atyapkin/S23-16_5G-mmWave-Up-Down-Converter-FPGA-Mezzanine-Card/S23-16_PCB/Downconverter.kicad_sch

## KiCad design S23-16_PCB/Downconverter.kicad_sch (2023-04-20)

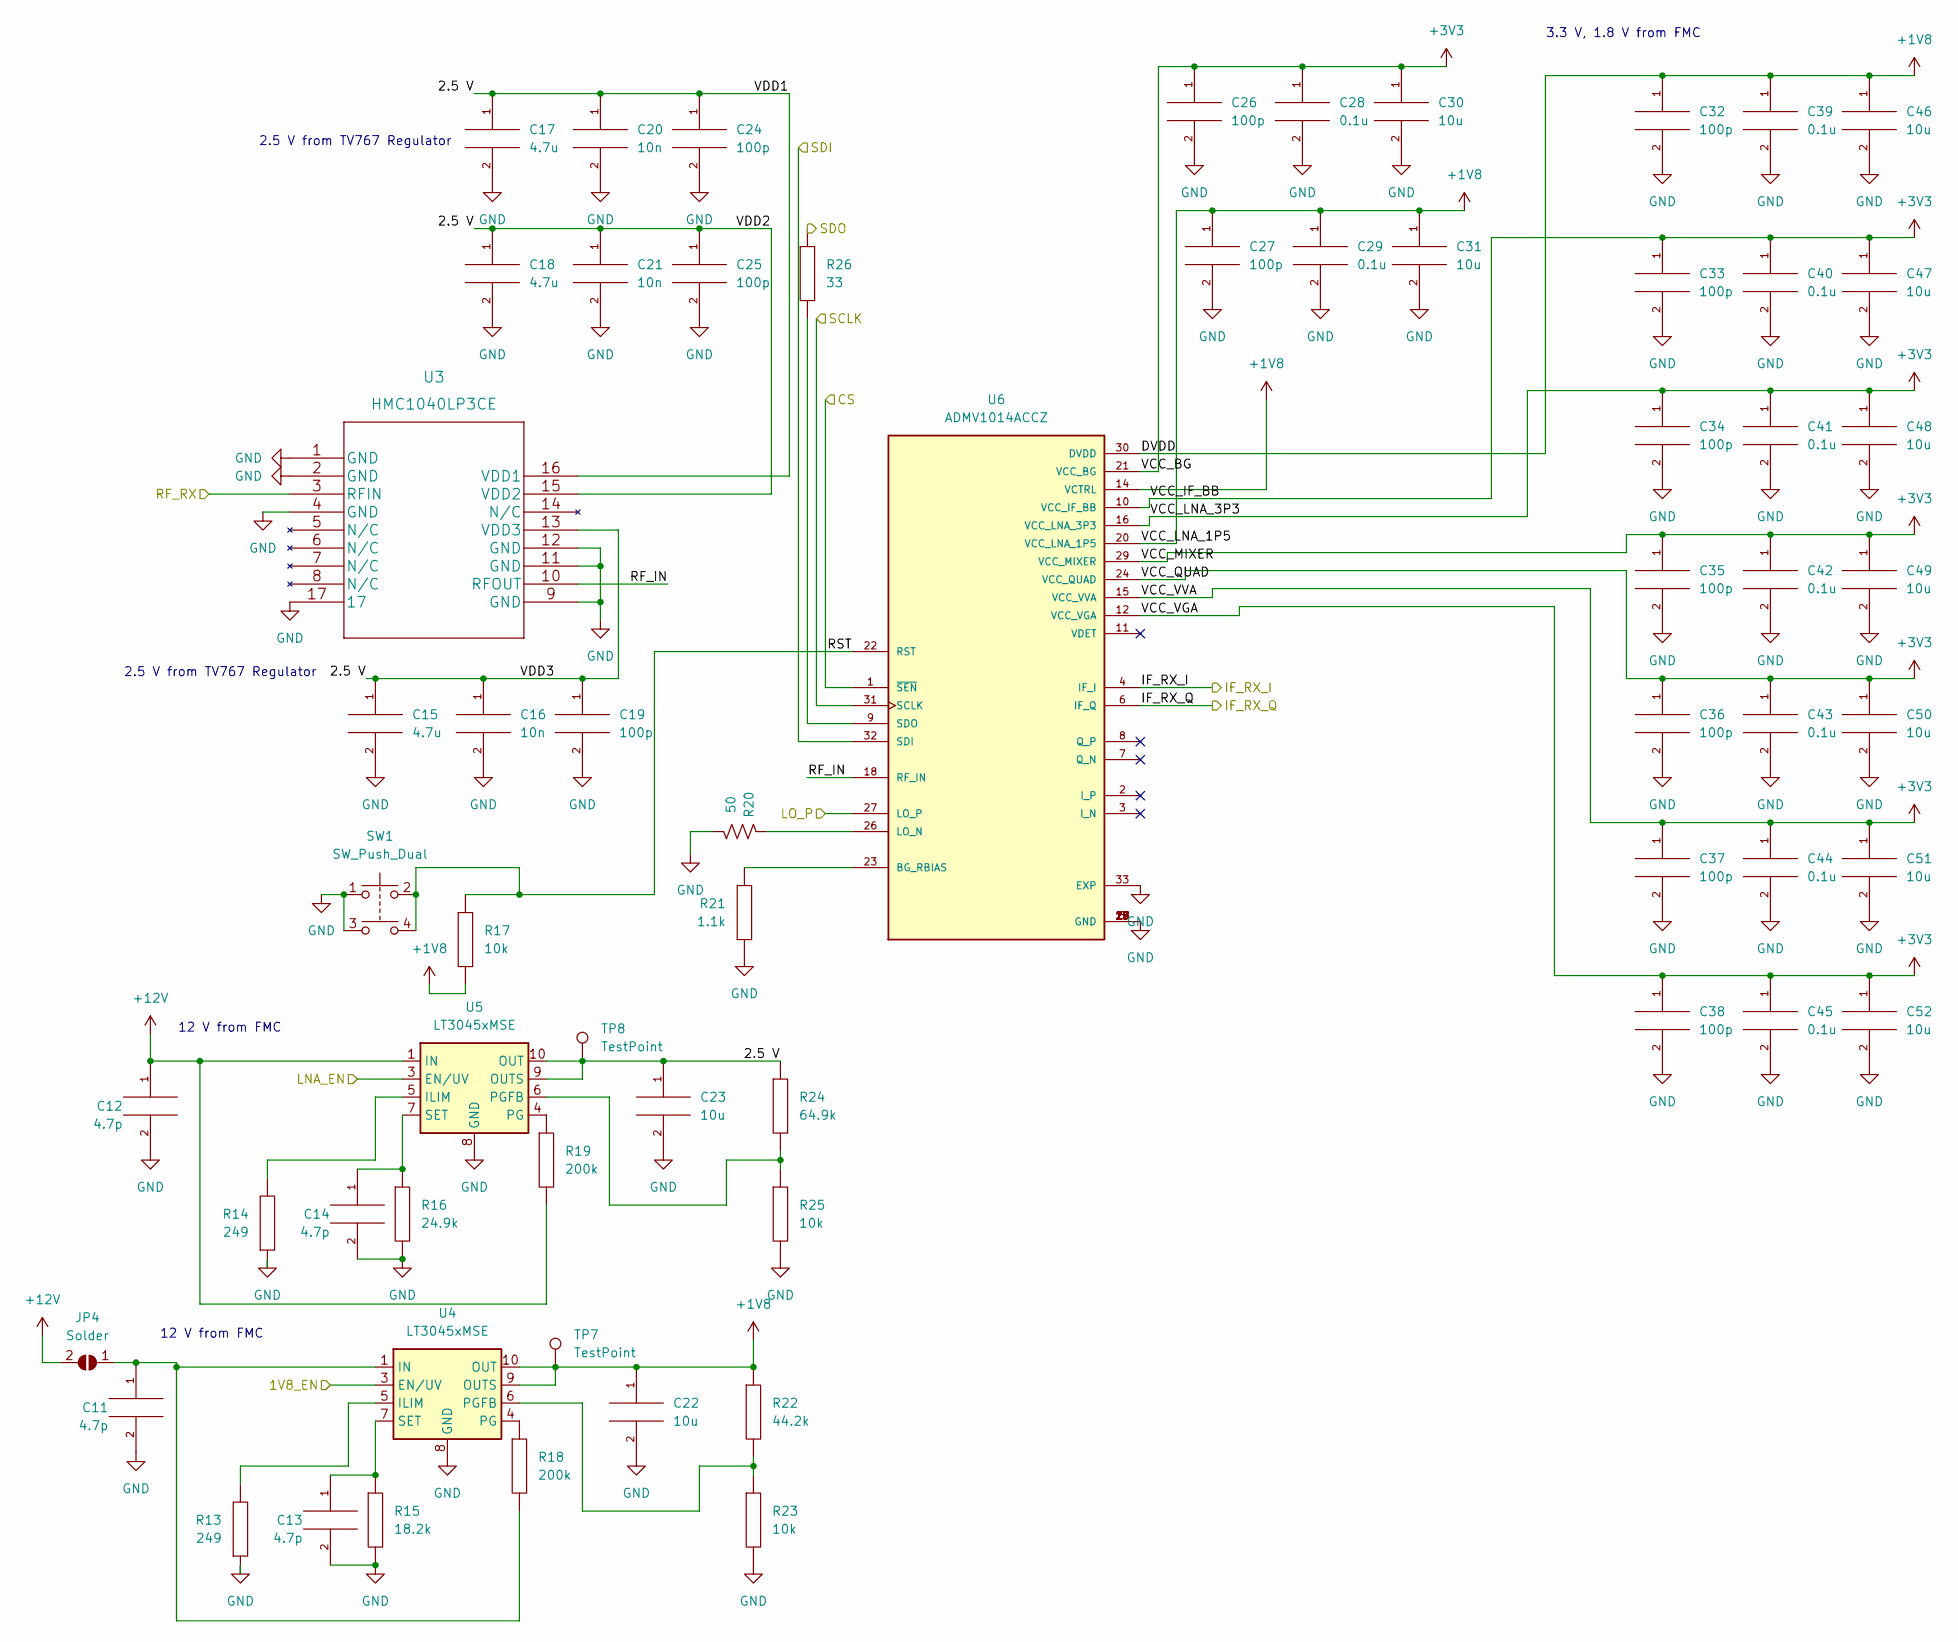
[picture p1: schematic Downconverter.kicad_sch]

Parts:
C11, C12, C13, C14: 4.7p; C_0402_1005Metric
C15, C17, C18: 4.7u; C_0402_1005Metric
C16, C20, C21: 10n; C_0402_1005Metric
C19, C24, C25, C26, C27, C32, C33, C34, C35, C36, C37, C38: 100p; C_0402_1005Metric
C22, C23: 10u; CP_EIA-3216-18_Kemet-A
C28, C29, C39, C40, C41, C42, C43, C44, C45: 0.1u; C_0402_1005Metric
C30, C31, C46, C47, C48, C49, C50, C51, C52: 10u; C_0402_1005Metric
JP4: Solder; SolderJumper-2_P1.3mm_Open_RoundedPad1.0x1.5mm
R13, R14: 249; R_0402_1005Metric
R15: 18.2k; R_0402_1005Metric
R16: 24.9k; R_0402_1005Metric
R17, R23, R25: 10k; R_0402_1005Metric
R18, R19: 200k; R_0402_1005Metric
R20: 50; R_0402_1005Metric
R21: 1.1k; R_0402_1005Metric
R22: 44.2k; R_0402_1005Metric
R24: 64.9k; R_0402_1005Metric
R26: 33; R_0402_1005Metric
SW1: SW_Push_Dual; SW_TL6330AF200Q
TP7, TP8: TestPoint; TestPoint_Loop_D2.50mm_Drill1.0mm
U3: HMC1040LP3CE
U4, U5: LT3045xMSE; DFN-10-1EP_3x3mm_P0.5mm_EP1.65x2.38mm
U6: ADMV1014ACCZ; PARTREV A

Connections:
1V8_EN: U4.3 (EN/UV)
2.5 V: C15.1, C16.1, C17.1, C18.1, C19.1, C20.1, C21.1, C23.1, C24.1, C25.1, R24.1, TP8.1, U3.13 (VDD3), U3.15 (VDD2), U3.16 (VDD1), U5.9 (OUTS), U5.10 (OUT), U5.12 (OUT)
+1V8: C22.1, C27.1, C29.1, C31.1, C32.1, C39.1, C46.1, R17.2, R22.1, TP7.1, U4.9 (OUTS), U4.10 (OUT), U4.12 (OUT), U6.14 (VCTRL), U6.20 (VCC_LNA_1P5), U6.30 (DVDD)
+3V3: C26.1, C28.1, C30.1, C33.1, C34.1, C35.1, C36.1, C37.1, C38.1, C40.1, C41.1, C42.1, C43.1, C44.1, C45.1, C47.1, C48.1, C49.1, C50.1, C51.1, C52.1, U6.10 (VCC_IF_BB), U6.12 (VCC_VGA), U6.15 (VCC_VVA), U6.16 (VCC_LNA_3P3), U6.21 (VCC_BG), U6.24 (VCC_QUAD), U6.29 (VCC_MIXER)
+12V: C12.1, JP4.2 (B), R19.2, U5.1 (IN), U5.2 (IN)
CS: U6.1 (~SEN)
GND: C11.2, C12.2, C13.2, C14.2, C15.2, C16.2, C17.2, C18.2, C19.2, C20.2, C21.2, C22.2, C23.2, C24.2, C25.2, C26.2, C27.2, C28.2, C29.2, C30.2, C31.2, C32.2, C33.2, C34.2, C35.2, C36.2, C37.2, C38.2, C39.2, C40.2, C41.2, C42.2, C43.2, C44.2, C45.2, C46.2, C47.2, C48.2, C49.2, C50.2, C51.2, C52.2, R13.1, R14.1, R15.2, R16.2, R20.1, R21.1, R23.2, R25.2, SW1.1, SW1.3, U3.1 (GND), U3.2 (GND), U3.4 (GND), U3.9 (GND), U3.11 (GND), U3.12 (GND), U3.17, U4.8 (GND), U4.11 (GND), U5.8 (GND), U5.11 (GND), U6.5 (GND), U6.13 (GND), U6.17 (GND), U6.19 (GND), U6.25 (GND), U6.28 (GND), U6.33 (EXP)
IF_RX_I: U6.4 (IF_I)
IF_RX_Q: U6.6 (IF_Q)
LNA_EN: U5.3 (EN/UV)
LO_P: U6.27 (LO_P)
unnamed: C11.1, JP4.1 (A), R18.2, U4.1 (IN), U4.2 (IN)
unnamed: C13.1, R15.1, U4.7 (SET)
unnamed: C14.1, R16.1, U5.7 (SET)
unnamed: R13.2, U4.5 (ILIM)
unnamed: R14.2, U5.5 (ILIM)
unnamed: R18.1, U4.4 (PG)
unnamed: R19.1, U5.4 (PG)
unnamed: R20.2, U6.26 (LO_N)
unnamed: R21.2, U6.23 (BG_RBIAS)
unnamed: R22.2, R23.1, U4.6 (PGFB)
unnamed: R24.2, R25.1, U5.6 (PGFB)
unnamed: R26.2, U6.9 (SDO)
RF_IN: U3.10 (RFOUT), U6.18 (RF_IN)
RF_RX: U3.3 (RFIN)
RST: R17.1, SW1.2, SW1.4, U6.22 (RST)
SCLK: U6.31 (SCLK)
SDI: U6.32 (SDI)
SDO: R26.1

Notes on the sheet:
12 V from FMC
3.3 V, 1.8 V from FMC
2.5 V from TV767 Regulator
