atyapkin/S23-16_5G-mmWave-Up-Down-Converter-FPGA-Mezzanine-Card/S23-16_PCB/FMC_plus.kicad_sch

## KiCad design S23-16_PCB/FMC_plus.kicad_sch (2023-04-20)

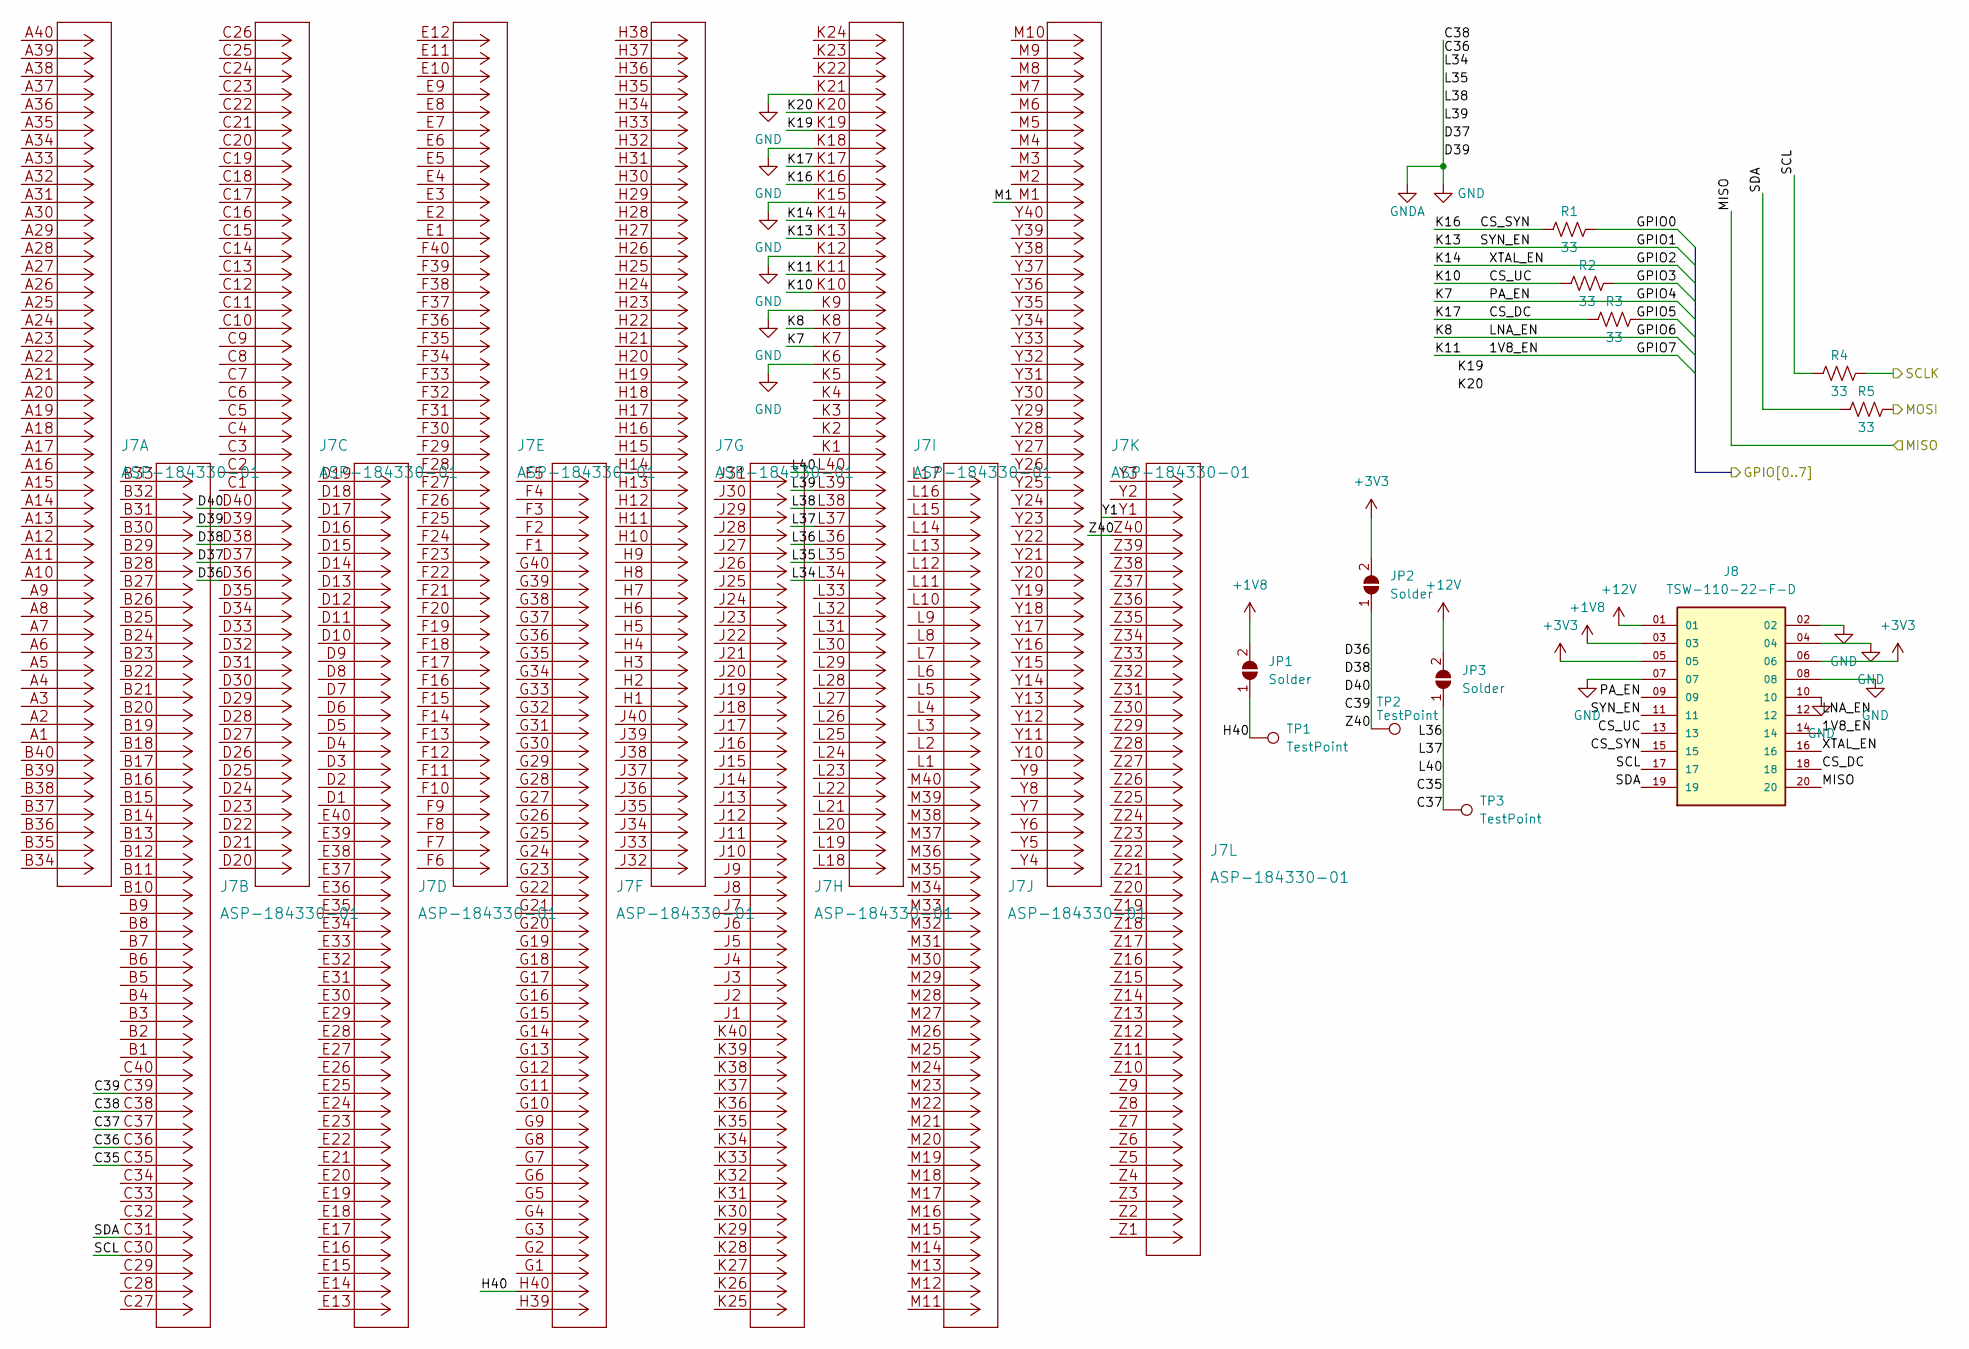
[picture p2: schematic FMC_plus.kicad_sch]

Parts:
J7: ASP-184330-01
J8: TSW-110-22-F-D; SAMTEC_TSW-110-22-F-D; PARTREV R
JP1, JP2, JP3: Solder; SolderJumper-2_P1.3mm_Open_RoundedPad1.0x1.5mm
R1, R2, R3, R4, R5: 33; R_0402_1005Metric
TP1, TP2, TP3: TestPoint; TestPoint_Loop_D2.50mm_Drill1.0mm

Connections:
1V8_EN: J7.K11, J8.14
+1V8: J8.03, JP1.2 (B)
+3V3: J8.05, J8.06, JP2.2 (B)
+12V: J8.01, JP3.2 (B)
C35: J7.C35, J7.C37, J7.L36, J7.L37, J7.L40, JP3.1 (A), TP3.1
C39: J7.C39, J7.D36, J7.D38, J7.D40, J7.Z40, JP2.1 (A), TP2.1
CS_DC: J7.K17, J8.18, R3.1
CS_SYN: J7.K16, J8.15, R1.1
CS_UC: J7.K10, J8.13, R2.1
GND: J7.C36, J7.C38, J7.D37, J7.D39, J7.K6, J7.K9, J7.K12, J7.K15, J7.K18, J7.K21, J7.L34, J7.L35, J7.L38, J7.L39, J8.02, J8.04, J8.07, J8.08, J8.10
GPIO0: R1.2
GPIO1: J7.K13, J8.11
GPIO2: J7.K14, J8.16
GPIO3: R2.2
GPIO4: J7.K7, J8.09
GPIO5: R3.2
GPIO6: J7.K8, J8.12
H40: J7.H40, JP1.1 (A), TP1.1
K19: J7.K19
K20: J7.K20
M1: J7.M1
MISO: J8.20
MOSI: R5.2
SCL: J7.C30, J8.17, R4.1
SCLK: R4.2
SDA: J7.C31, J8.19, R5.1
Y1: J7.Y1
