atyapkin/S23-16_5G-mmWave-Up-Down-Converter-FPGA-Mezzanine-Card/S23-16_PCB/S23-16_PCB.kicad_sch

## KiCad design S23-16_PCB/S23-16_PCB.kicad_sch (2023-04-20)

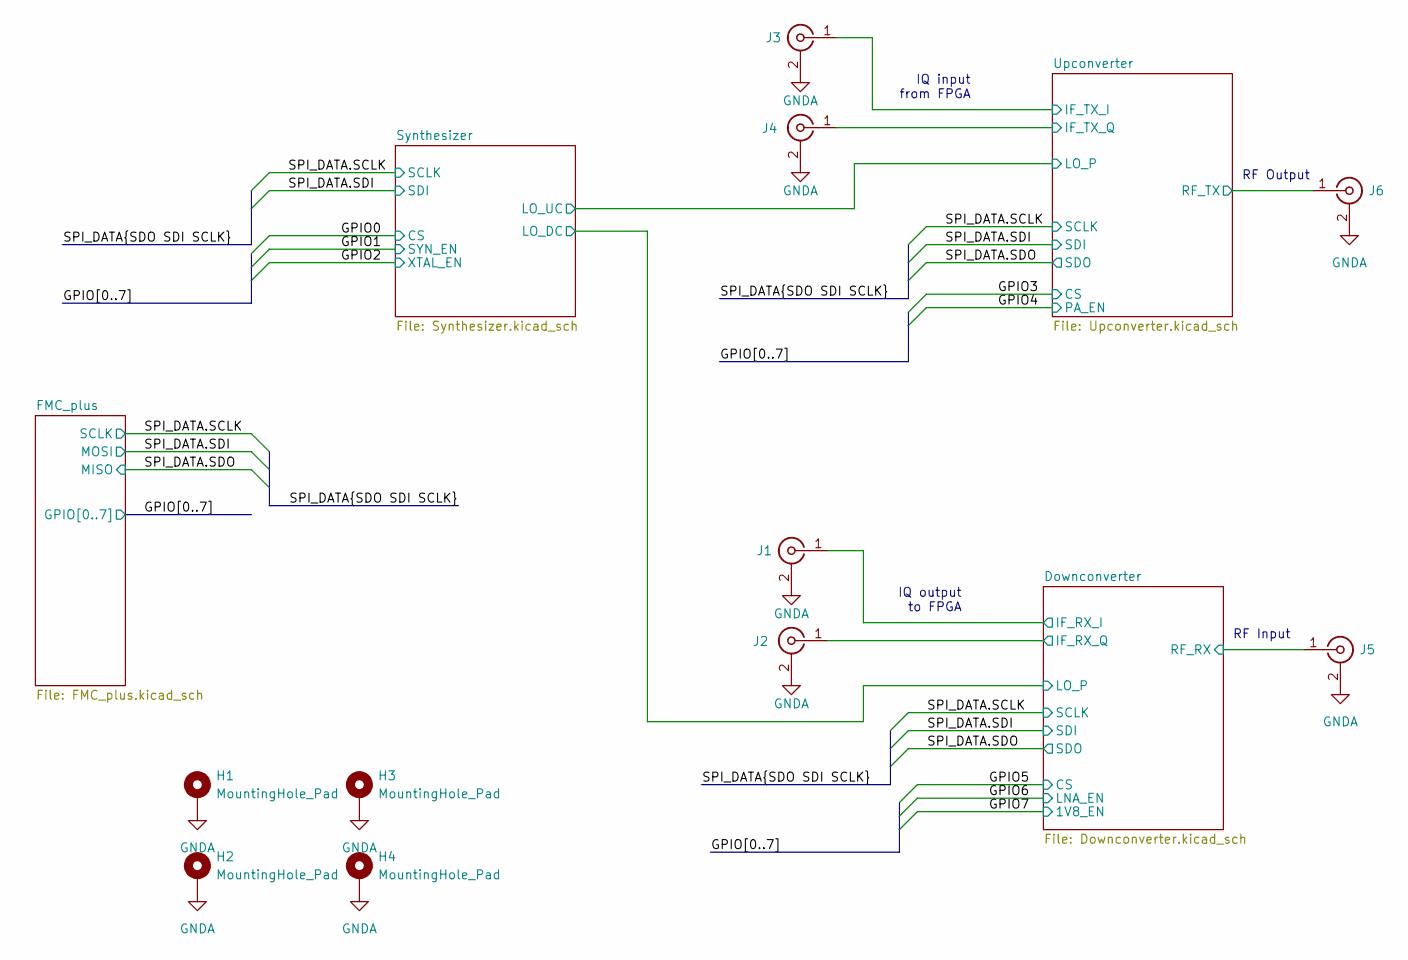
[picture p3: schematic S23-16_PCB.kicad_sch]

Parts:
H1, H2, H3, H4: MountingHole_Pad; MountingHole_3.2mm_M3_Pad_TopBottom
J1, J2, J3, J4: J; SMA_Samtec_SMA-J-P-X-ST-EM1_EdgeMount
J5, J6: J; 1092-0xA-14

Connections:
GNDA: H1.1, H2.1, H3.1, H4.1, J1.2 (Ext), J2.2 (Ext), J3.2 (Ext), J4.2 (Ext), J5.2 (Ext), J6.2 (Ext)
IF_RX_I: J1.1 (In)
IF_RX_Q: J2.1 (In)
IF_TX_I: J3.1 (In)
IF_TX_Q: J4.1 (In)
RF_RX: J5.1 (In)
RF_TX: J6.1 (In)

Notes on the sheet:
IQ input from FPGA
RF Output
RF Input
IQ output to FPGA
