atyapkin/S23-16_5G-mmWave-Up-Down-Converter-FPGA-Mezzanine-Card/S23-16_PCB/Synthesizer.kicad_sch

## KiCad design S23-16_PCB/Synthesizer.kicad_sch (2023-04-20)

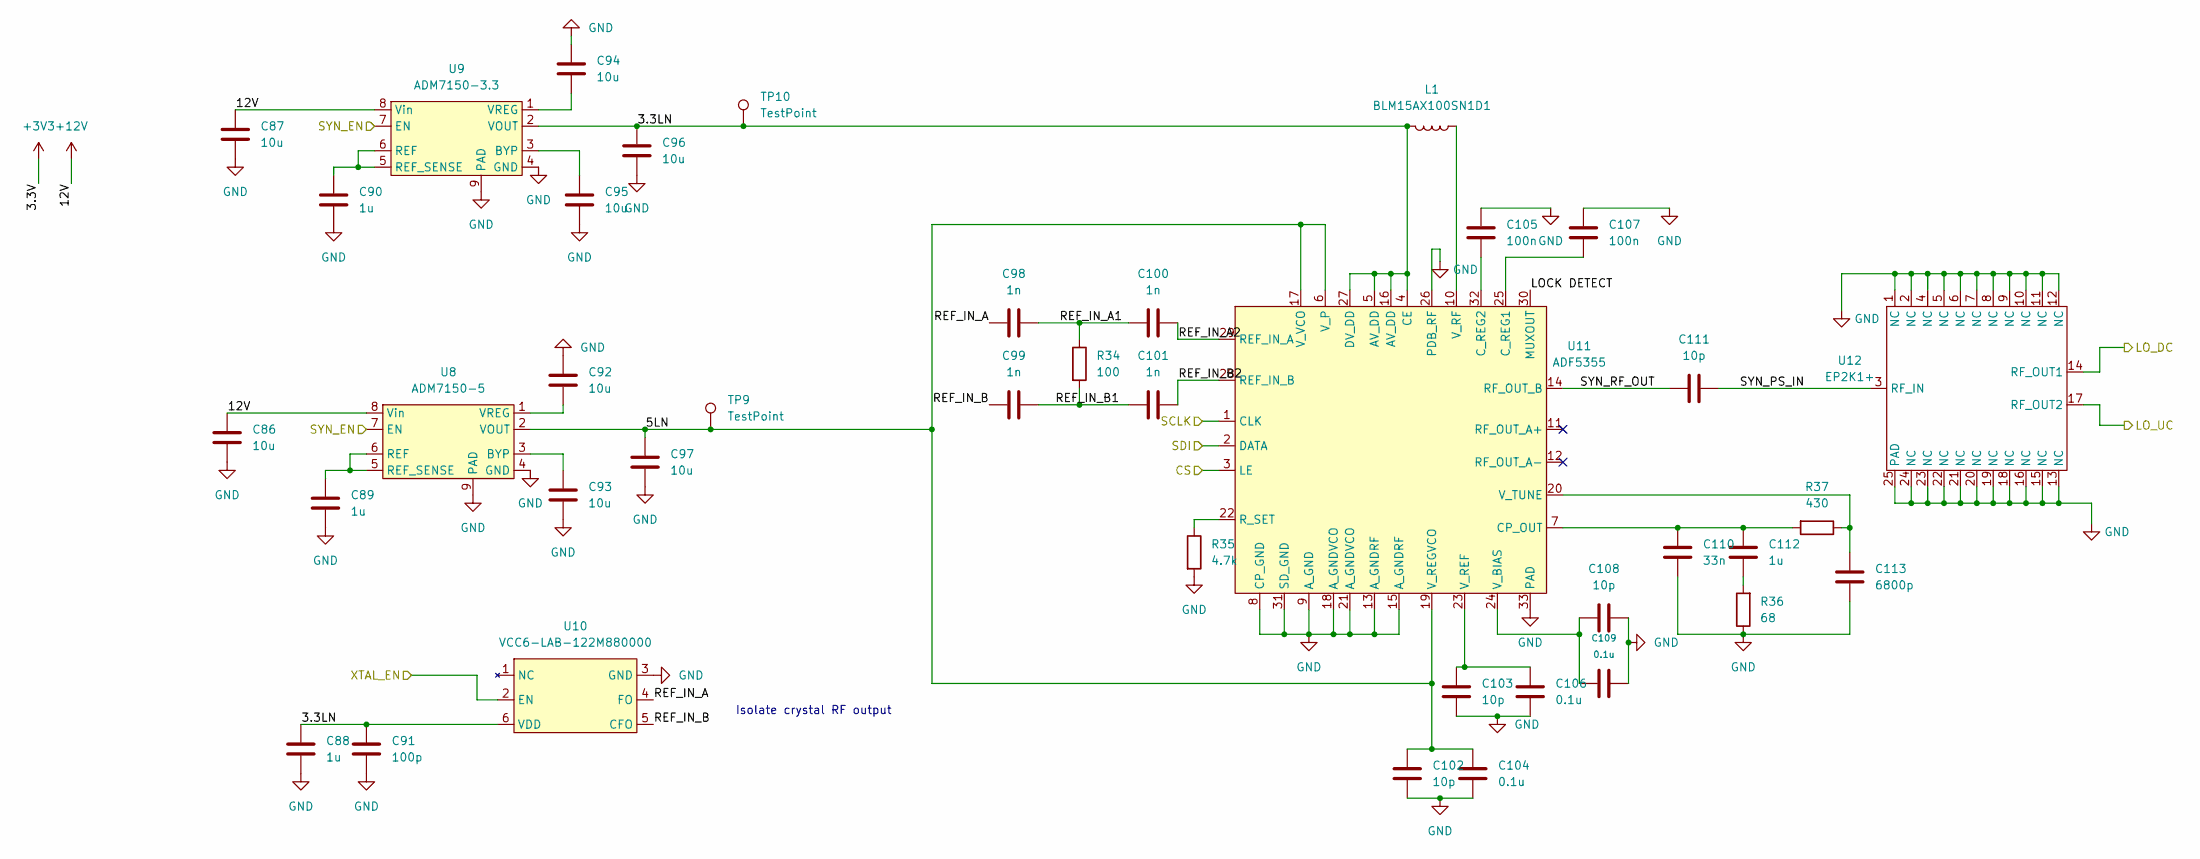
[picture p4: schematic Synthesizer.kicad_sch]

Parts:
C86, C87, C92, C93, C94, C95, C96, C97: 10u; C_0402_1005Metric
C88, C89, C90, C112: 1u; C_0402_1005Metric
C91: 100p; C_0402_1005Metric
C98, C99, C100, C101: 1n; C_0402_1005Metric
C102, C103, C108: 10p; C_0402_1005Metric
C104, C106, C109: 0.1u; C_0402_1005Metric
C105, C107: 100n; C_0402_1005Metric
C110: 33n; C_0402_1005Metric
C111: 10p; C_0201_0603Metric
C113: 6800p; C_0402_1005Metric
L1: BLM15AX100SN1D1; L_0402_1005Metric_Pad0.77x0.64mm_HandSolder
R34: 100; R_0402_1005Metric
R35: 4.7k; R_0402_1005Metric
R36: 68; R_0402_1005Metric
R37: 430; R_0402_1005Metric
TP9, TP10: TestPoint; TestPoint_Loop_D2.50mm_Drill1.0mm
U8: ADM7150-5; DFN300X300X80-9N
U9: ADM7150-3.3; DFN300X300X80-9N
U10: VCC6-LAB-122M880000; VCC6
U11: ADF5355; ADF5355BCPZ
U12: EP2K1+; LFCSP-24-1EP_4x4mm_P0.5mm_EP2.5x2.5mm

Connections:
3.3LN: C88.1, C91.1, C96.2, L1.2, TP10.1, U9.2 (VOUT), U10.6 (VDD), U11.4 (CE), U11.5 (AV_DD), U11.16 (AV_DD), U11.27 (DV_DD)
5LN: C97.1, C102.1, C104.1, TP9.1, U8.2 (VOUT), U11.6 (V_P), U11.17 (V_VCO), U11.19 (V_REGVCO)
+12V: C86.2, C87.2, U8.8 (Vin), U9.8 (Vin)
CS: U11.3 (LE)
GND: C86.1, C87.1, C88.2, C89.2, C90.2, C91.2, C92.1, C93.2, C94.1, C95.2, C96.1, C97.2, C102.2, C103.2, C104.2, C105.1, C106.2, C107.1, C108.2, C109.2, C110.2, C113.2, R35.2, R36.1, U8.4 (GND), U8.9 (PAD), U9.4 (GND), U9.9 (PAD), U10.3 (GND), U11.8 (CP_GND), U11.9 (A_GND), U11.13 (A_GNDRF), U11.15 (A_GNDRF), U11.18 (A_GNDVCO), U11.21 (A_GNDVCO), U11.26 (PDB_RF), U11.31 (SD_GND), U11.33 (PAD), U12.1 (NC), U12.2 (NC), U12.4 (NC), U12.5 (NC), U12.6 (NC), U12.7 (NC), U12.8 (NC), U12.9 (NC), U12.10 (NC), U12.11 (NC), U12.12 (NC), U12.13 (NC), U12.15 (NC), U12.16 (NC), U12.18 (NC), U12.19 (NC), U12.20 (NC), U12.21 (NC), U12.22 (NC), U12.23 (NC), U12.24 (NC), U12.25 (PAD)
LOCK DETECT: U11.30 (MUXOUT)
LO_DC: U12.14 (RF_OUT1)
LO_UC: U12.17 (RF_OUT2)
unnamed: C89.1, U8.5 (REF_SENSE), U8.6 (REF)
unnamed: C90.1, U9.5 (REF_SENSE), U9.6 (REF)
unnamed: C92.2, U8.1 (VREG)
unnamed: C93.1, U8.3 (BYP)
unnamed: C94.2, U9.1 (VREG)
unnamed: C95.1, U9.3 (BYP)
unnamed: C103.1, C106.1, U11.23 (V_REF)
unnamed: C105.2, U11.32 (C_REG2)
unnamed: C107.2, U11.25 (C_REG1)
unnamed: C108.1, C109.1, U11.24 (V_BIAS)
unnamed: C110.1, C112.1, R37.2, U11.7 (CP_OUT)
unnamed: C112.2, R36.2
unnamed: C113.1, R37.1, U11.20 (V_TUNE)
unnamed: L1.1, U11.10 (V_RF)
unnamed: R35.1, U11.22 (R_SET)
REF_IN_A: C98.1, U10.4 (FO)
REF_IN_A1: C98.2, C100.1, R34.1
REF_IN_A2: C100.2, U11.29 (REF_IN_A)
REF_IN_B: C99.1, U10.5 (CFO)
REF_IN_B1: C99.2, C101.1, R34.2
REF_IN_B2: C101.2, U11.28 (REF_IN_B)
SCLK: U11.1 (CLK)
SDI: U11.2 (DATA)
SYN_EN: U8.7 (EN), U9.7 (EN)
SYN_PS_IN: C111.2, U12.3 (RF_IN)
SYN_RF_OUT: C111.1, U11.14 (RF_OUT_B)
XTAL_EN: U10.2 (EN)

Notes on the sheet:
Isolate crystal RF output
