atyapkin/S23-16_5G-mmWave-Up-Down-Converter-FPGA-Mezzanine-Card/S23-16_PCB/Upconverter.kicad_sch

## KiCad design S23-16_PCB/Upconverter.kicad_sch (2023-04-20)

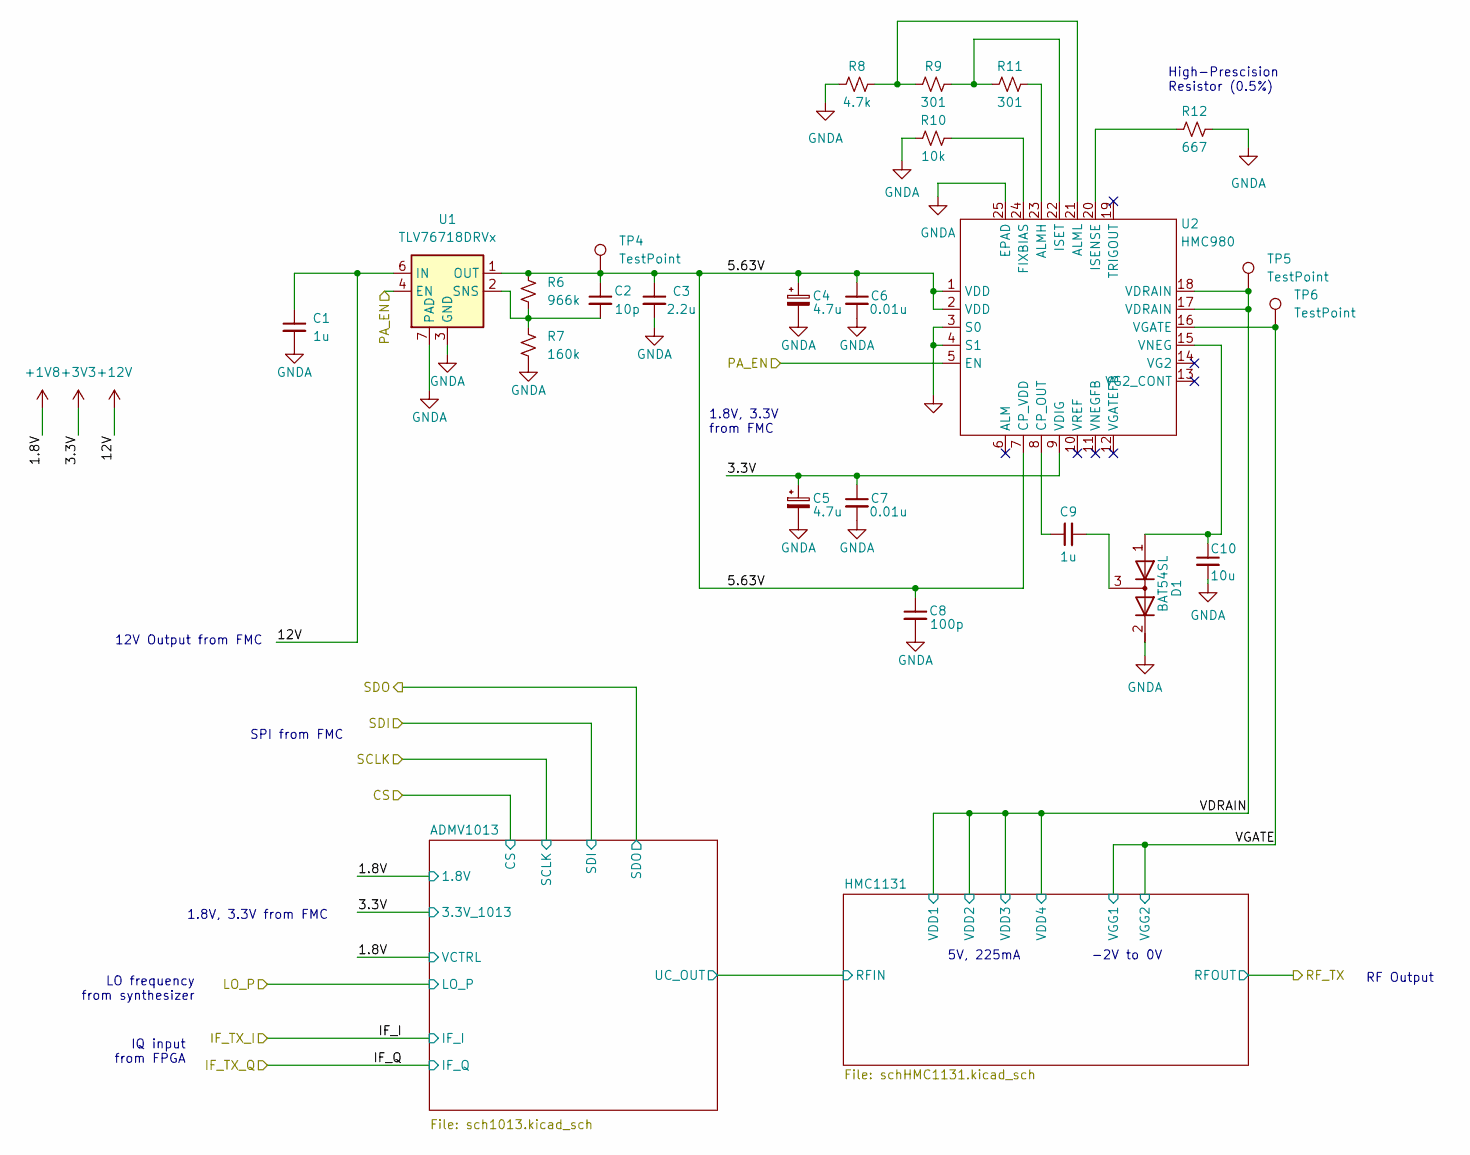
[picture p5: schematic Upconverter.kicad_sch]

Parts:
C1: 1u; C_0603_1608Metric; Part No. GRM1885C1H103JA01J
C2: 10p; C_0402_1005Metric; Part No. GCM1555C1H120JA16J
C3: 2.2u; C_0603_1608Metric; Part No. C0603C225K4PAC7867
C4, C5: 4.7u; CP_EIA-1608-08_AVX-J_Pad1.25x1.05mm_HandSolder; Part No. TAJA475K016UNJ
C6, C7: 0.01u; C_0402_1005Metric; Part No. GRM1885C1H103JA01J
C8: 100p; C_0402_1005Metric; Part No. GCM1555G1H101JA16D
C9: 1u; C_0603_1608Metric; Part No. C1608X5R1H105K080AB
C10: 10u; C_0805_2012Metric; Part No. C2012X5R1V106K125AC
D1: BAT54SL; SOT95P237X111-3N; Part No. BAT54SLT1G
R6: 966k; R_0402_1005Metric; Part No. AC0402FR-07976KL
R7: 160k; R_0402_1005Metric; Part No. AC0402FR-07160KL
R8: 4.7k; R_0402_1005Metric
R9, R11: 301; R_0402_1005Metric
R10: 10k; R_0402_1005Metric
R12: 667; R_0402_1005Metric
TP4, TP5, TP6: TestPoint; TestPoint_Loop_D2.50mm_Drill1.0mm
U1: TLV76718DRVx; WSON-6-1EP_2x2mm_P0.65mm_EP1x1.6mm
U2: HMC980; LFCSP-24-1EP_4x4mm_P0.5mm_EP2.5x2.5mm

Connections:
5.63V: C2.1, C3.1, C4.1, C6.1, C8.1, R6.1, TP4.1, U1.1 (OUT), U2.1 (VDD), U2.2 (VDD), U2.7 (CP_VDD)
+3V3: C5.1, C7.1, U2.9 (VDIG)
+12V: C1.1, U1.6 (IN)
GNDA: C1.2, C3.2, C4.2, C5.2, C6.2, C7.2, C8.2, C10.2, D1.2 (K), R7.2, R8.1, R10.1, R12.2, U1.3 (GND), U1.5 (GND), U1.7 (PAD), U2.25 (EPAD)
unnamed: C2.2, R6.2, R7.1, U1.2 (SNS)
unnamed: C9.1, U2.8 (CP_OUT)
unnamed: C9.2, D1.3 (common)
unnamed: C10.1, D1.1 (A), U2.15 (VNEG)
unnamed: R8.2, R9.1, U2.21 (ALML)
unnamed: R10.2, U2.24 (FIXBIAS)
unnamed: R9.2, R11.1, U2.22 (ISET)
unnamed: R11.2, U2.23 (ALMH)
unnamed: R12.1, U2.20 (ISENSE)
PA_EN: U1.4 (EN), U2.5 (EN)
VDRAIN: TP5.1, U2.17 (VDRAIN), U2.18 (VDRAIN)
VGATE: TP6.1, U2.16 (VGATE)
~: U2.3 (S0), U2.4 (S1)

Notes on the sheet:
LO frequency from synthesizer
1.8V, 3.3V from FMC
5V, 225mA
RF Output
1.8V, 3.3V from FMC
IQ input from FPGA
12V Output from FMC
-2V to 0V
High-Prescision Resistor (0.5%)
SPI from FMC
