atyapkin/S23-16_5G-mmWave-Up-Down-Converter-FPGA-Mezzanine-Card/S23-16_PCB/sch1013.kicad_sch

## KiCad design S23-16_PCB/sch1013.kicad_sch (2023-04-20)

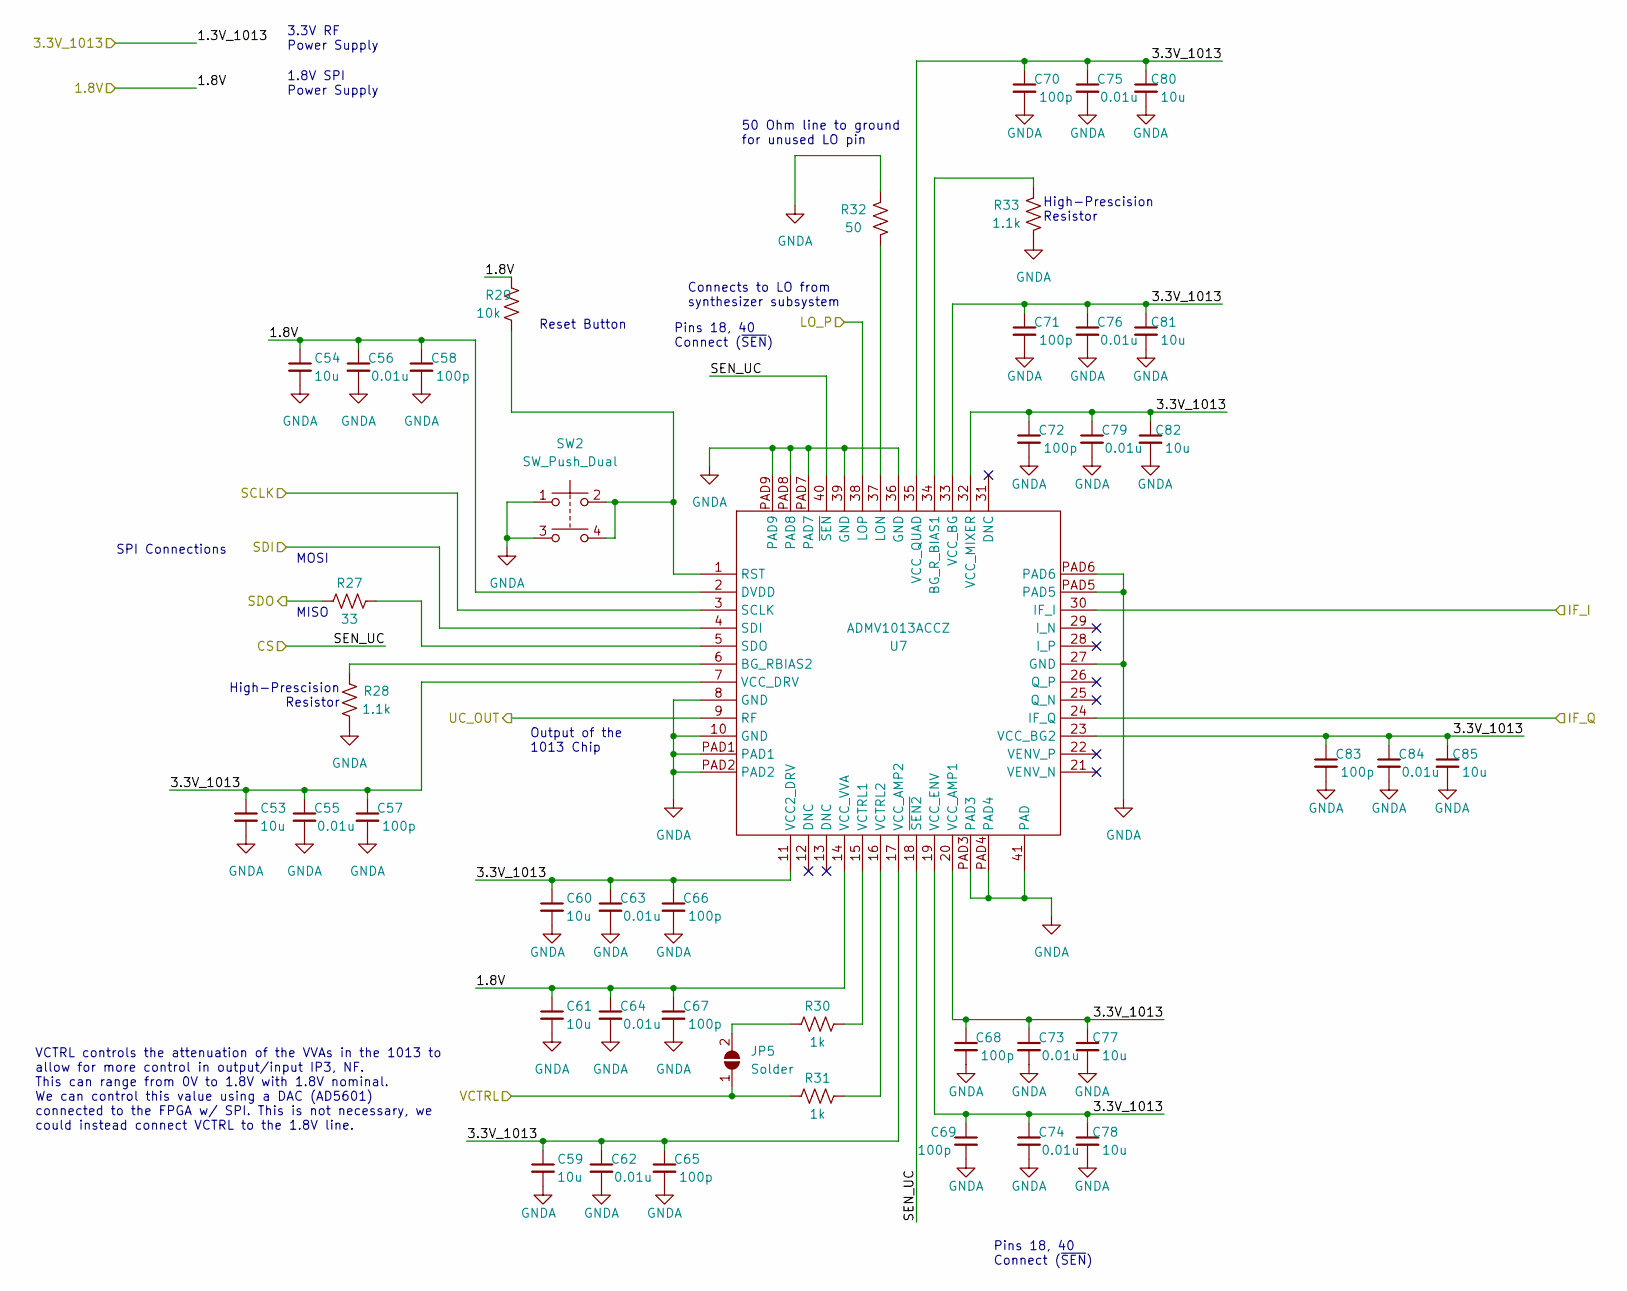
[picture p6: schematic sch1013.kicad_sch]

Parts:
C53, C54, C59, C60, C61, C77, C78, C80, C81, C82, C85: 10u; C_0402_1005Metric
C55, C56, C62, C63, C64, C73, C74, C75, C76, C79, C84: 0.01u; C_0402_1005Metric
C57, C58, C65, C66, C67, C68, C69, C70, C71, C72, C83: 100p; C_0402_1005Metric
JP5: Solder; SolderJumper-2_P1.3mm_Open_RoundedPad1.0x1.5mm
R27: 33; R_0402_1005Metric
R28, R33: 1.1k; R_0402_1005Metric
R29: 10k; R_0402_1005Metric
R30, R31: 1k; R_0402_1005Metric
R32: 50; R_0402_1005Metric
SW2: SW_Push_Dual; SW_TL6330AF200Q
U7: ADMV1013ACCZ

Connections:
1.8V: C54.1, C56.1, C58.1, C61.1, C64.1, C67.1, R29.1, U7.2 (DVDD), U7.14 (VCC_VVA)
3.3V_1013: C53.1, C55.1, C57.1, C59.1, C60.1, C62.1, C63.1, C65.1, C66.1, C68.1, C69.1, C70.1, C71.1, C72.1, C73.1, C74.1, C75.1, C76.1, C77.1, C78.1, C79.1, C80.1, C81.1, C82.1, C83.1, C84.1, C85.1, U7.7 (VCC_DRV), U7.11 (VCC2_DRV), U7.17 (VCC_AMP2), U7.19 (VCC_ENV), U7.20 (VCC_AMP1), U7.23 (VCC_BG2), U7.32 (VCC_MIXER), U7.33 (VCC_BG), U7.35 (VCC_QUAD)
CS: U7.18 (~SEN2), U7.40 (~SEN)
GNDA: C53.2, C54.2, C55.2, C56.2, C57.2, C58.2, C59.2, C60.2, C61.2, C62.2, C63.2, C64.2, C65.2, C66.2, C67.2, C68.2, C69.2, C70.2, C71.2, C72.2, C73.2, C74.2, C75.2, C76.2, C77.2, C78.2, C79.2, C80.2, C81.2, C82.2, C83.2, C84.2, C85.2, R28.1, R32.2, R33.1, SW2.1, SW2.3, U7.8 (GND), U7.10 (GND), U7.27 (GND), U7.36 (GND), U7.39 (GND), U7.41 (PAD), U7.PAD1, U7.PAD2, U7.PAD3, U7.PAD4, U7.PAD5, U7.PAD6, U7.PAD7, U7.PAD8, U7.PAD9
IF_I: U7.30 (IF_I)
IF_Q: U7.24 (IF_Q)
LO_P: U7.38 (LOP)
unnamed: JP5.2 (B), R30.1
unnamed: R27.2, U7.5 (SDO)
unnamed: R28.2, U7.6 (BG_RBIAS2)
unnamed: R29.2, SW2.2, SW2.4, U7.1 (RST)
unnamed: R30.2, U7.15 (VCTRL1)
unnamed: R31.2, U7.16 (VCTRL2)
unnamed: R32.1, U7.37 (LON)
unnamed: R33.2, U7.34 (BG_R_BIAS1)
SCLK: U7.3 (SCLK)
SDI: U7.4 (SDI)
SDO: R27.1
UC_OUT: U7.9 (RF)
VCTRL: JP5.1 (A), R31.1

Notes on the sheet:
Pins 18, 40 Connect (~{SEN})
High-Prescision Resistor
Output of the 1013 Chip
Connects to LO from synthesizer subsystem
Reset Button
VCTRL controls the attenuation of the VVAs in the 1013 to allow for more control in output/input IP3, NF. This can range from 0V to 1.8V with 1.8V nominal. We can control this value using a DAC (AD5601) connected to the FPGA w/ SPI. This is not necessary, we could instead connect VCTRL to the 1.8V 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
MISO
3.3V RF Power Supply
50 Ohm line to ground for unused LO pin
1.8V SPI Power Supply
SPI Connections
MOSI
