atyapkin/S23-16_5G-mmWave-Up-Down-Converter-FPGA-Mezzanine-Card/S23-16_PCB/schHMC1131.kicad_sch

## KiCad design S23-16_PCB/schHMC1131.kicad_sch (2023-04-20)

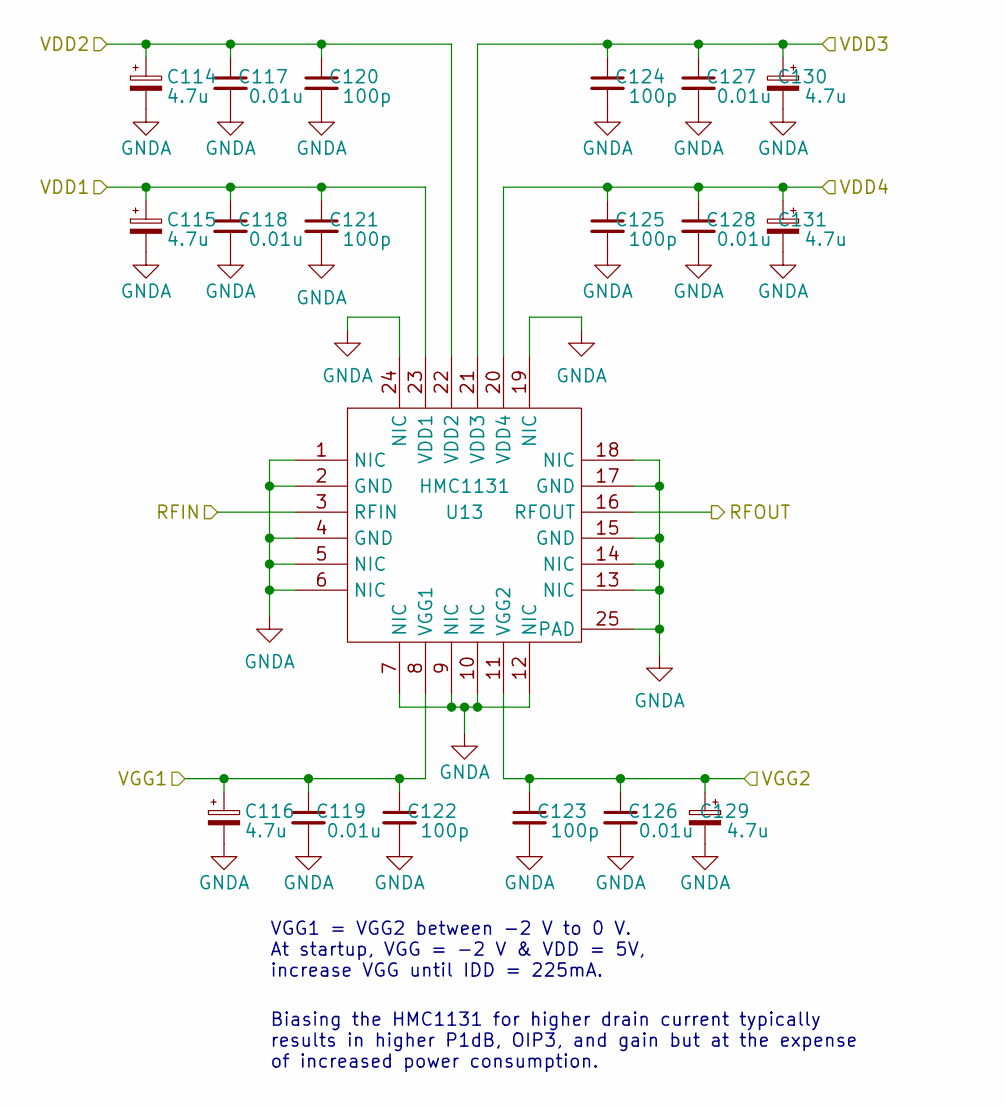
[picture p7: schematic schHMC1131.kicad_sch]

Parts:
C114, C115, C116: 4.7u; CP_EIA-1608-08_AVX-J_Pad1.25x1.05mm_HandSolder
C117, C118, C119, C126, C127, C128: 0.01u; C_0402_1005Metric
C120, C121, C122, C123, C124, C125: 100p; C_0402_1005Metric
C129, C130, C131: 4.7u; CP_EIA-1608-10_AVX-L_Pad1.25x1.05mm_HandSolder
U13: HMC1131; HMC1131LC4TR

Connections:
GNDA: C114.2, C115.2, C116.2, C117.2, C118.2, C119.2, C120.2, C121.2, C122.2, C123.2, C124.2, C125.2, C126.2, C127.2, C128.2, C129.2, C130.2, C131.2, U13.1 (NIC), U13.2 (GND), U13.4 (GND), U13.5 (NIC), U13.6 (NIC), U13.7 (NIC), U13.9 (NIC), U13.10 (NIC), U13.12 (NIC), U13.13 (NIC), U13.14 (NIC), U13.15 (GND), U13.17 (GND), U13.18 (NIC), U13.19 (NIC), U13.24 (NIC), U13.25 (PAD)
RFIN: U13.3 (RFIN)
RFOUT: U13.16 (RFOUT)
VDD1: C115.1, C118.1, C121.1, U13.23 (VDD1)
VDD2: C114.1, C117.1, C120.1, U13.22 (VDD2)
VDD3: C124.1, C127.1, C130.1, U13.21 (VDD3)
VDD4: C125.1, C128.1, C131.1, U13.20 (VDD4)
VGG1: C116.1, C119.1, C122.1, U13.8 (VGG1)
VGG2: C123.1, C126.1, C129.1, U13.11 (VGG2)

Notes on the sheet:
Biasing the HMC1131 for higher drain current typically results in higher P1dB, OIP3, and gain but at the expense of increased power consumption.
VGG1 = VGG2 between -2 V to 0 V. At startup, VGG = -2 V & VDD = 5V, increase VGG until IDD = 225mA.
