atyapkin/S23-16_5G-mmWave-Up-Down-Converter-FPGA-Mezzanine-Card/(commit log)

2023-04-20 Add files via upload
    Initial commit of PCB design
    [Downconverter.kicad_sch, FMC_plus.kicad_sch, S23-16_PCB.kicad_sch, Synthesizer.kicad_sch, Upconverter.kicad_sch, sch1013.kicad_sch, schHMC1131.kicad_sch]
2023-04-20 Add files via upload
    Added all PCB design and fab files
    [Downconverter.kicad_sch, FMC_plus.kicad_sch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]
2023-04-20 Delete Downconverter.kicad_sch
    duplicate file
    [Downconverter.kicad_sch]
2023-04-20 Delete FMC_plus.kicad_sch
    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
    [FMC_plus.kicad_sch]
2023-04-20 Delete FMC_plus.kicad_sch-bak
    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
2023-04-20 Delete S23-16_PCB.kicad_pcb
    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
2023-04-20 Delete S23-16_PCB.kicad_prl
    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
2023-04-20 Delete S23-16_PCB.kicad_pro
    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
2023-04-20 Delete S23-16_PCB.kicad_sch
    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
    [S23-16_PCB.kicad_sch]
2023-04-20 Delete Synthesizer.kicad_sch
    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
    [Synthesizer.kicad_sch]
2023-04-20 Delete Upconverter.kicad_sch
    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
    [Upconverter.kicad_sch]
2023-04-20 Delete sch1013.kicad_sch
    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
    [sch1013.kicad_sch]
2023-04-20 Delete sch1013.kicad_sch-bak
    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
2023-04-20 Delete schHMC1131.kicad_sch
    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
    [schHMC1131.kicad_sch]
2023-04-20 Delete S23-16_PCB/S23_16_Library.pretty directory
    Missing footprints and 3D models
2023-04-20 Add files via upload
    Uploaded missing footprints and 3D models
2023-04-20 Update README.md
    Added info on file naming conventions for Gerber and drill files
2023-04-20 Add files via upload
    Added missing schematic files
    [Synthesizer.kicad_sch, Upconverter.kicad_sch, sch1013.kicad_sch, schHMC1131.kicad_sch]
2023-04-20 Update README.md
    Added schematic and PCB files description sections
2023-04-20 Update README.md
    Added BOM section
